gourireddy/fire-extinguishing-drone/firmware/esp32_cam_gc2145/camera_pins.h

#ifndef CAMERA_PINS_H
#define CAMERA_PINS_H

// ESP32-S3 Camera Pin Mapping for Freenove / ESP32-S3-WROOM-1 / ESP32-S3-EYE
// with 24-pin DVP socket (RHYX M21-45 / GC2145)

#define PWDN_GPIO_NUM     -1
#define RESET_GPIO_NUM    -1
#define XCLK_GPIO_NUM     15
#define SIOD_GPIO_NUM      4  // SCCB / I2C SDA
#define SIOC_GPIO_NUM      5  // SCCB / I2C SCL

#define Y9_GPIO_NUM       16  // D7
#define Y8_GPIO_NUM       17  // D6
#define Y7_GPIO_NUM       18  // D5
#define Y6_GPIO_NUM       12  // D4
#define Y5_GPIO_NUM       10  // D3
#define Y4_GPIO_NUM        8  // D2
#define Y3_GPIO_NUM        9  // D1
#define Y2_GPIO_NUM       11  // D0

#define VSYNC_GPIO_NUM     6
#define HREF_GPIO_NUM      7
#define PCLK_GPIO_NUM     13

#endif // CAMERA_PINS_H
