gourireddy/fire-extinguishing-drone/firmware/esp32_cam_gc2145/wifi_credentials.h

#ifndef WIFI_CREDENTIALS_H
#define WIFI_CREDENTIALS_H

// Local Wi-Fi Configuration
// Defaulting to your laptop's current active 2.4 GHz network
const char* WIFI_SSID = "7 STAR 11";
const char* WIFI_PASS = "GKV@0309";

#endif // WIFI_CREDENTIALS_H
