gourireddy/fire-extinguishing-drone/(notices)

Notices in the files:
README.md:
License: MIT
